tiagosandoval/tdse-tpf_1-05/roadmap.md

W16
- lectura_pote -> Tiago
- lectura_imu -> Tomás

W17
- movimiento_servo -> Tomás 
- imprimir_ángulo_LCD -> Tiago

W21?
- PID (servo + IMU)
- máquina de estados
- interfaz (estados, botones)
- integrar todo
