tiagosandoval/tdse-tpf_1-05/Core/Inc/main.h

#define B1_Pin GPIO_PIN_13
#define B1_GPIO_Port GPIOC
#define B1_EXTI_IRQn EXTI15_10_IRQn
#define USART_TX_Pin GPIO_PIN_2
#define USART_TX_GPIO_Port GPIOA
#define USART_RX_Pin GPIO_PIN_3
#define USART_RX_GPIO_Port GPIOA
#define LD2_Pin GPIO_PIN_5
#define LD2_GPIO_Port GPIOA
#define D12_Pin GPIO_PIN_6
#define D12_GPIO_Port GPIOA
#define D11_Pin GPIO_PIN_7
#define D11_GPIO_Port GPIOA
#define D6_Pin GPIO_PIN_10
#define D6_GPIO_Port GPIOB
#define D9_Pin GPIO_PIN_7
#define D9_GPIO_Port GPIOC
#define D7_Pin GPIO_PIN_8
#define D7_GPIO_Port GPIOA
#define D8_Pin GPIO_PIN_9
#define D8_GPIO_Port GPIOA
#define D2_Pin GPIO_PIN_10
#define D2_GPIO_Port GPIOA
#define TMS_Pin GPIO_PIN_13
#define TMS_GPIO_Port GPIOA
#define TCK_Pin GPIO_PIN_14
#define TCK_GPIO_Port GPIOA
#define SWO_Pin GPIO_PIN_3
#define SWO_GPIO_Port GPIOB
#define D5_Pin GPIO_PIN_4
#define D5_GPIO_Port GPIOB
#define D4_Pin GPIO_PIN_5
#define D4_GPIO_Port GPIOB
#define D10_Pin GPIO_PIN_6
#define D10_GPIO_Port GPIOB
