tiagosandoval/tdse-tpf_1-05/(commit log)

2026-04-14 roadmap para las próximas semanas
    al final nunca lo habia subido jajaj
2026-04-18 actualización roadmap para W17
2026-04-18 lectura de potenciometro
    [ADC.cfg]
2026-04-19 lectura del ángulo de la IMU
2026-04-19 agregado readme al proyecto de la IMU
2026-04-21 código para mover el servo
2026-08-06 Relocalizado códigos de otros proyectos. Pruebas controlador PI funcionando, con esquema de organizador de tareas
    [ADC.cfg, tdse-tpf-estabilizador-servo-imu.cfg]
2026-08-08 agrego la parte integrada
    [tdse-tpf-integrado.cfg]
2026-08-12 Emprolijado: código integrado, agregado de tabla de transiciones y de la statechart creada en Itemis Create
    [tdse-tpf-estabilizador-servo-imu.cfg, tdse-tpf-integrado.cfg]
2026-08-12 agrego link de la demo del prototipo
2026-08-12 retoques: readme.md, adjuntadas imágenes, cambio de nombre de macro de producción, subido el script que se usó para encontrar el eje correcto de la IMU
    [app.c, app.h]
